eltradec/SCSI2SD-Proc/readme

Master is for CY8C5268
Branch is for CY8C5468
