eltradec/SCSI2SD-Proc/kicad/scsi2sd12.pdf

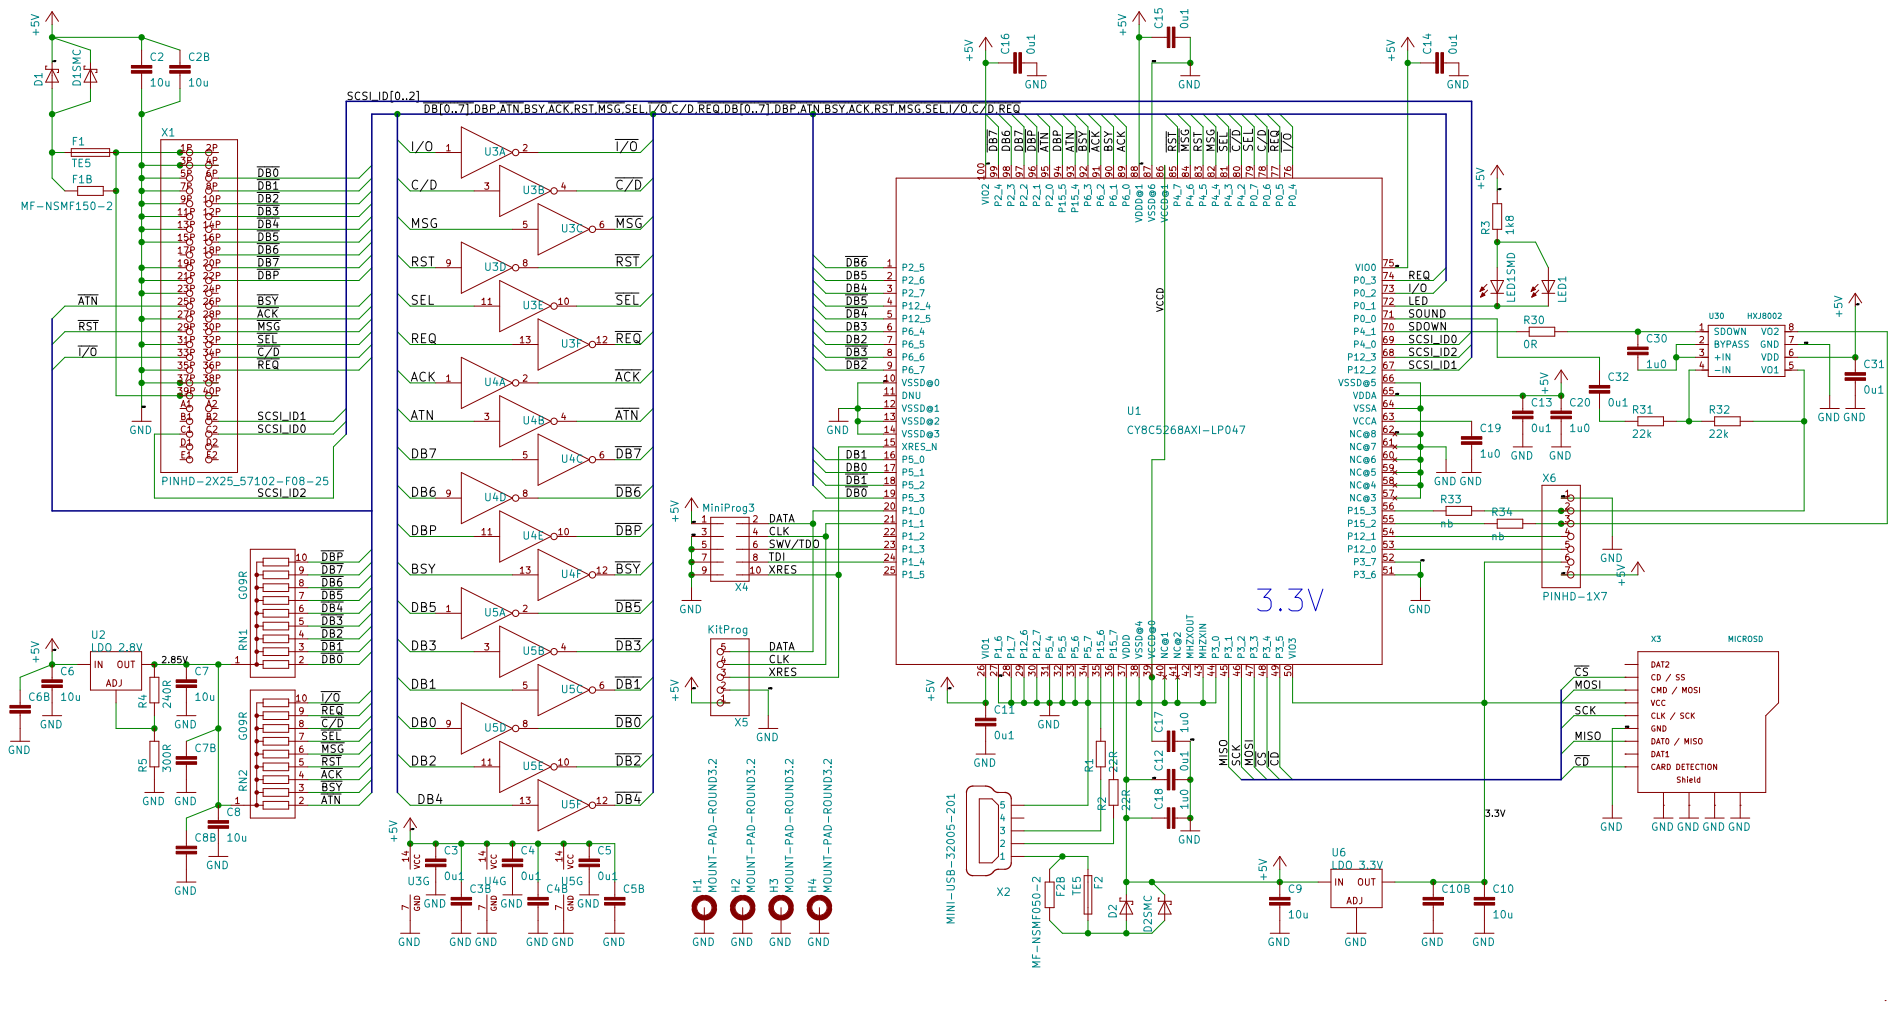
[picture p1: page 1]

DB[0..7],DBP,ATN,BSY,ACK,RST,MSG,SEL,I/O,C/D,REQ,DB[0..7],DBP,ATN,BSY,ACK,RST,MSG,SEL,I/O,C/D,REQ

CLK CLK DATA DATA

4 5 6

SWV/TDO
TDI

DAT1 DAT2 GND
CD / SS CLK / SCK CMD / MOSI DAT0 / MISO
