eltradec/SCSI2SD-Proc/kicad/scsi2sd12.sch

## KiCad design kicad/scsi2sd12.sch (2019-03-16)

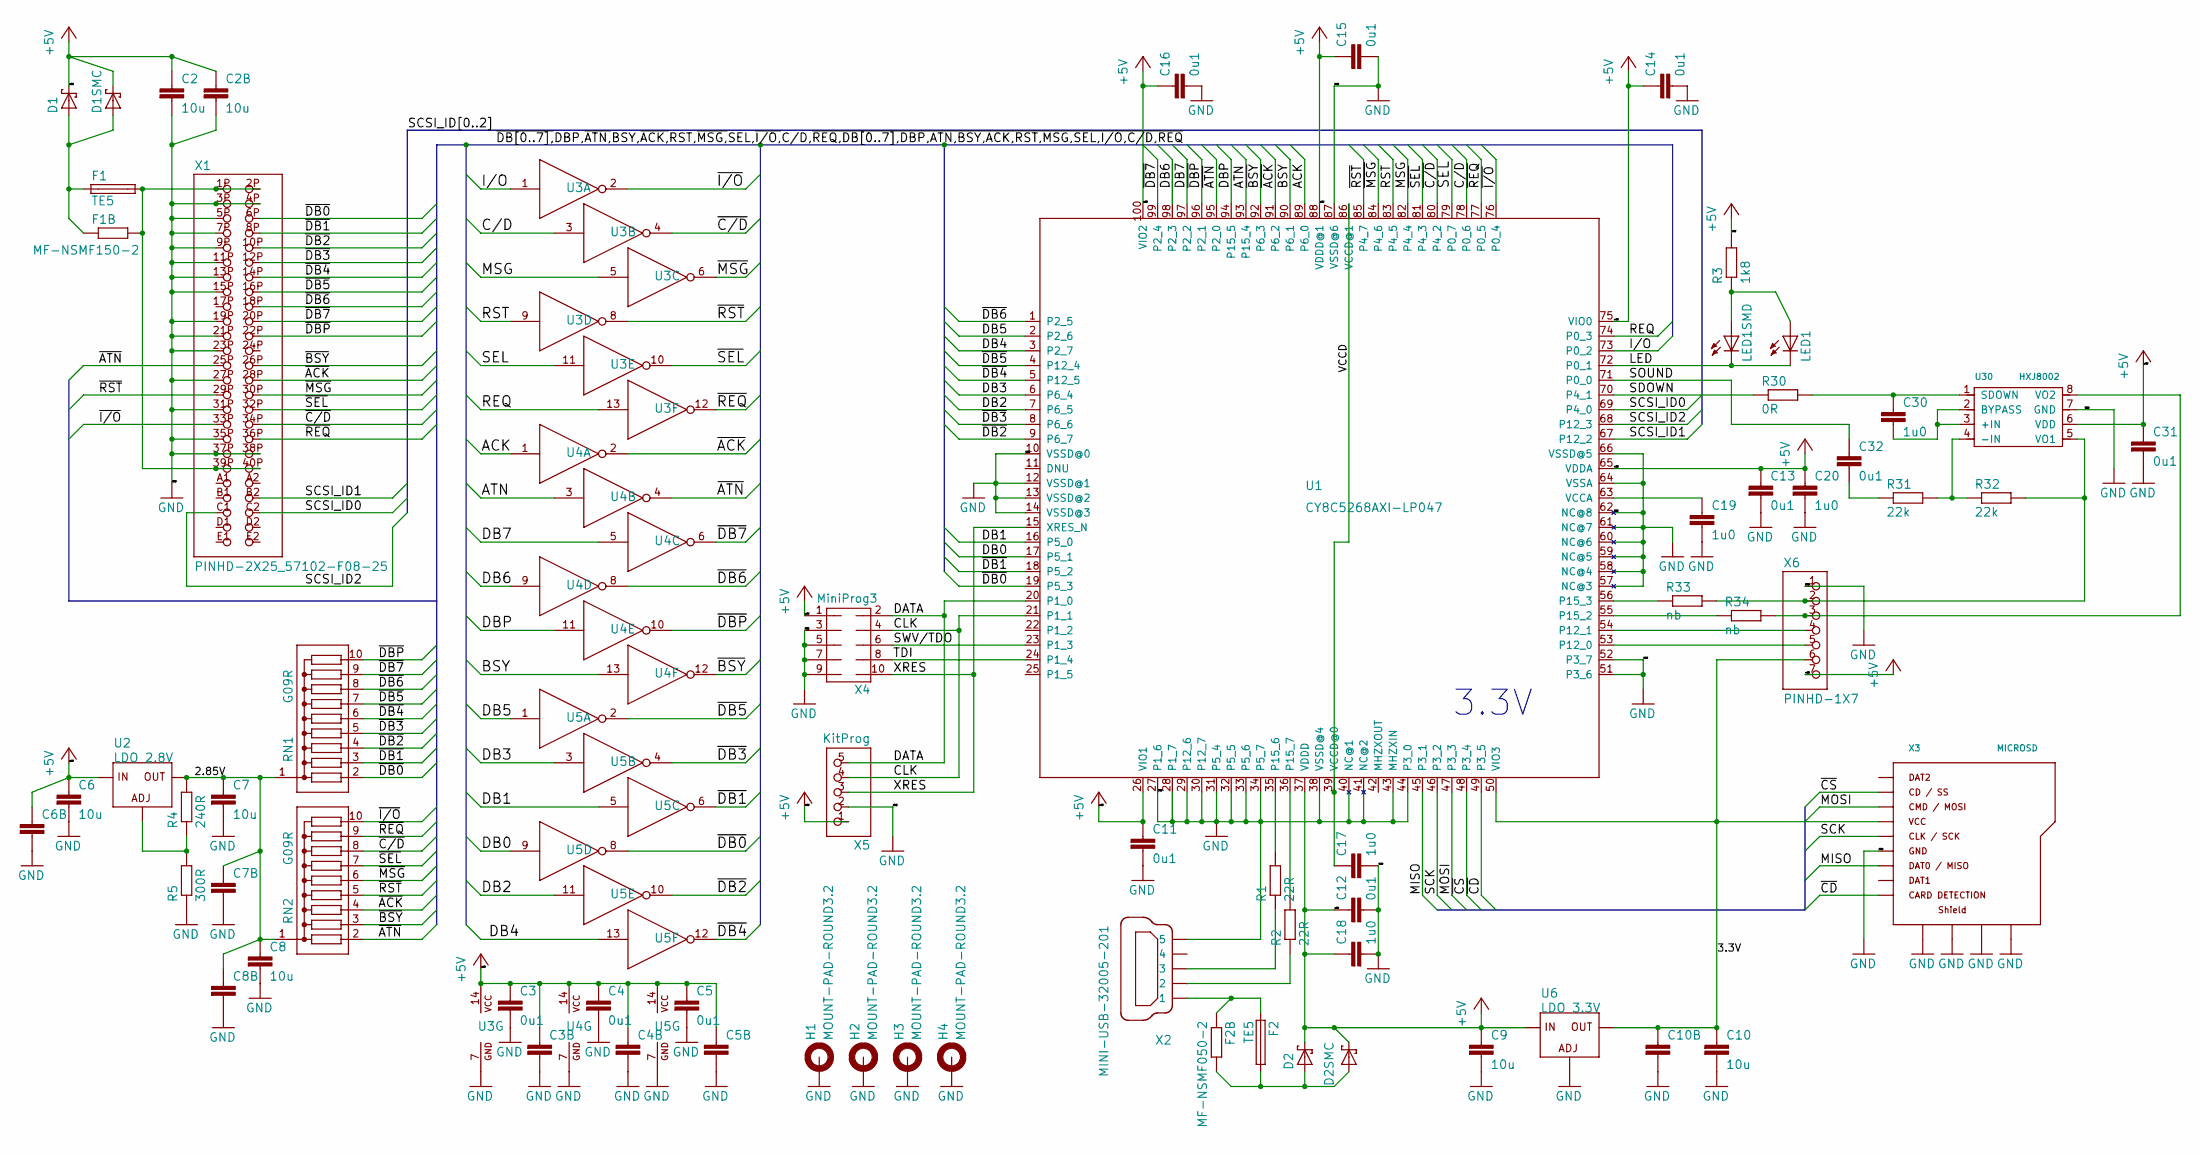
[picture p2: schematic scsi2sd12.sch]

Parts:
C2, C6, C7, C8, C9, C10: 10u; C0805K
C2B, C6B, C7B, C8B, C10B: 10u; C1206K
C3, C4, C5, C15: 0u1; C0603K
C3B, C4B, C5B, C11, C12, C13, C14, C16, C31, C32: 0u1; C0805K
C17, C18, C19, C20, C30: 1u0; C0805K
D1, D2: SCHOTTKY-DIODEDO214AC; DO214AC
D1SMC, D2SMC: SCHOTTKY-DIODESMC; SMC
F1, F2: TE5
F1B: MF-NSMF150-2; R1206
F2B: MF-NSMF050-2; R1206
H1, H2, H3, H4: MOUNT-PAD-ROUND3.2; 3,2-PAD
LED1: LEDCHIPLED_0805; CHIPLED_0805
LED1SMD: LED3MM
R1, R2: 22R; M0805
R3: 1k8; R0805
R4: 240R; M0805
R5: 300R; M0805
R30: 0R; M0805
R31, R32: 22k; M0805
R33, R34: nb; M0805
RN1, RN2: G09R; SIL10
U1: CY8C5268AXI-LP047; TQFP100-14X14
U2: LDO 2.8V; DPACK
U3, U4, U5: 7406D; SO14
U6: LDO 3.3V; DPACK
U30: HXJ8002; SOIC8-1.27-5X4MM
X1: PINHD-2X25_57102-F08-25; 57102-F08-25
X2: MINI-USB-32005-201; 32005-201
X3: MICROSD; MR**-AP*03**
X4: MiniProg3; PHB_1MM27_2X05_SNS
X5: KitProg; 1X05
X6: PINHD-1X7; 1X07

Connections:
2.85V: C7.1, C7B.1, C8.1, C8B.1, R4.2, RN1.1, RN2.1, U2.4 (OUT)
3.3V: C10.1, C10B.1, U1.50 (VIO3), U6.4 (OUT), X3.VCC, X6.6
+5V: C2.1, C2B.1, C3.1, C3B.1, C4.1, C4B.1, C5.1, C5B.1, C6.1, C6B.1, C9.1, C11.1, C12.1, C13.1, C14.1, C15.1, C16.1, C18.1, C20.1, C31.1, D1.C, D1SMC.C, D2.C, D2SMC.C, R3.2, U1.26 (VIO1), U1.37 (VDDD), U1.65 (VDDA), U1.75 (VIO0), U1.88 (VDDD@1), U1.100 (VIO2), U2.3 (IN), U3.14 (VCC), U4.14 (VCC), U5.14 (VCC), U6.3 (IN), U30.6 (VDD), X4.1, X5.1, X6.7
ACK: U1.89 (P6_0), U4.1 (I)
ATN: U1.93 (P15_4), U4.3 (I)
BSY: U1.90 (P6_1), U4.13 (I)
C/D: U1.78 (P0_6), U3.3 (I)
CLK: U1.21 (P1_1), X4.4, X5.4
DATA: U1.20 (P1_0), X4.2, X5.5
DB0: U1.17 (P5_1), U5.9 (I)
DB1: U1.16 (P5_0), U5.5 (I)
DB2: U1.7 (P6_5), U5.11 (I)
DB3: U1.6 (P6_4), U5.3 (I)
DB4: U1.3 (P2_7), U5.13 (I)
DB5: U1.2 (P2_6), U5.1 (I)
DB6: U1.98 (P2_3), U4.9 (I)
DB7: U1.97 (P2_2), U4.5 (I)
DBP: U1.94 (P15_5), U4.11 (I)
GND: C2.2, C2B.2, C3.2, C3B.2, C4.2, C4B.2, C5.2, C5B.2, C6.2, C6B.2, C7.2, C7B.2, C8.2, C8B.2, C9.2, C10.2, C10B.2, C11.2, C12.2, C13.2, C14.2, C15.2, C16.2, C17.2, C18.2, C19.2, C20.2, C31.2, H1.B3,2, H2.B3,2, H3.B3,2, H4.B3,2, R5.1, U1.10 (VSSD@0), U1.12 (VSSD@1), U1.13 (VSSD@2), U1.14 (VSSD@3), U1.27 (P1_6), U1.28 (P1_7), U1.29 (P12_6), U1.30 (P12_7), U1.31 (P5_4), U1.32 (P5_5), U1.33 (P5_6), U1.34 (P5_7), U1.38 (VSSD@4), U1.40 (NC@1), U1.41 (NC@2), U1.43 (MHZXIN), U1.44 (P3_0), U1.51 (P3_6), U1.52 (P3_7), U1.57 (NC@3), U1.58 (NC@4), U1.59 (NC@5), U1.60 (NC@6), U1.61 (NC@7), U1.62 (NC@8), U1.64 (VSSA), U1.66 (VSSD@5), U1.87 (VSSD@6), U3.7 (GND), U4.7 (GND), U5.7 (GND), U6.1 (ADJ), U30.7 (GND), X1.3P (3), X1.4P (4), X1.5P (5), X1.7P (7), X1.9P (9), X1.11P (11), X1.13P (13), X1.15P (15), X1.19P (19), X1.21P (21), X1.23P (23), X1.27P (27), X1.31P (31), X1.35P (35), X1.37P (37), X1.38P (38), X2.5, X3.GND, X3.SHD_1 (SHD1), X3.SHD_2 (SHD2), X3.SHD_3 (SHD3), X3.SHD_4 (SHD4), X4.3, X4.5, X4.7, X4.9, X5.2, X6.1
I/O: U1.73 (P0_2), U3.1 (I)
LED: LED1.C, LED1SMD.K (C), U1.72 (P0_1)
MISO: U1.45 (P3_1), X3.DAT0 (DAT0/MISO)
MOSI: U1.47 (P3_3), X3.CMD (CMD/MOSI)
MSG: U1.82 (P4_4), U3.5 (I)
unnamed: C19.1, U1.63 (VCCA)
unnamed: C30.1, R30.2, U30.1 (SDOWN)
unnamed: C30.2, U30.2 (BYPASS), U30.3 (+IN)
unnamed: C32.2, R31.1
unnamed: D1.A, D1SMC.A, F1.1, F1B.1
unnamed: D2.A, D2SMC.A, F2.2, F2B.2
unnamed: F1.2, F1B.2, X1.1P (1), X1.2P (2), X1.39P (39), X1.40P (40)
unnamed: F2.1, F2B.1, X2.1
unnamed: LED1.A, LED1SMD.A, R3.1
unnamed: R1.1, X2.3
unnamed: R1.2, U1.35 (P15_6)
unnamed: R2.1, X2.2
unnamed: R2.2, U1.36 (P15_7)
unnamed: R4.1, R5.2, U2.1 (ADJ)
unnamed: R31.2, R32.1, U30.4 (-IN)
unnamed: R32.2, R33.2, U30.5 (VO1), X6.2
unnamed: R33.1, U1.56 (P15_3)
unnamed: R34.1, U1.55 (P15_2)
unnamed: R34.2, U30.8 (VO2), X6.3
unnamed: U1.53 (P12_0), X6.5
unnamed: U1.54 (P12_1), X6.4
REQ: U1.74 (P0_3), U3.13 (I)
RST: U1.83 (P4_5), U3.9 (I)
SCK: U1.46 (P3_2), X3.CLK (CLK/SCK)
SCSI_ID0: U1.69 (P4_0), X1.C2 (46)
SCSI_ID1: U1.67 (P12_2), X1.B2 (44)
SCSI_ID2: U1.68 (P12_3), X1.C1 (45)
SDOWN: R30.1, U1.70 (P4_1)
SEL: U1.79 (P0_7), U3.11 (I)
SOUND: C32.1, U1.71 (P0_0)
SWV/TDO: U1.23 (P1_3), X4.6
TDI: U1.24 (P1_4), X4.8
VCCD: C17.1, U1.39 (VCCD@0), U1.86 (VCCD@1)
XRES: U1.15 (XRES_N), X4.10, X5.3
~ACK: RN2.4, U1.91 (P6_2), U4.2 (O), X1.28P (28)
~ATN: RN2.2, U1.95 (P2_0), U4.4 (O), X1.25P (25)
~BSY: RN2.3, U1.92 (P6_3), U4.12 (O), X1.26P (26)
~C/D: RN2.8, U1.80 (P4_2), U3.4 (O), X1.34P (34)
~CD: U1.49 (P3_5), X3.CARD_DETECTION (CARD_D)
~CS: U1.48 (P3_4), X3.DAT3/CS (CD/SS)
~DB0: RN1.2, U1.19 (P5_3), U5.8 (O), X1.6P (6)
~DB1: RN1.3, U1.18 (P5_2), U5.6 (O), X1.8P (8)
~DB2: RN1.4, U1.9 (P6_7), U5.10 (O), X1.10P (10)
~DB3: RN1.5, U1.8 (P6_6), U5.4 (O), X1.12P (12)
~DB4: RN1.6, U1.5 (P12_5), U5.12 (O), X1.14P (14)
~DB5: RN1.7, U1.4 (P12_4), U5.2 (O), X1.16P (16)
~DB6: RN1.8, U1.1 (P2_5), U4.8 (O), X1.18P (18)
~DB7: RN1.9, U1.99 (P2_4), U4.6 (O), X1.20P (20)
~DBP: RN1.10, U1.96 (P2_1), U4.10 (O), X1.22P (22)
~I/O: RN2.10, U1.76 (P0_4), U3.2 (O), X1.33P (33)
~MSG: RN2.6, U1.84 (P4_6), U3.6 (O), X1.30P (30)
~REQ: RN2.9, U1.77 (P0_5), U3.12 (O), X1.36P (36)
~RST: RN2.5, U1.85 (P4_7), U3.8 (O), X1.29P (29)
~SEL: RN2.7, U1.81 (P4_3), U3.10 (O), X1.32P (32)

Notes on the sheet:
3.3V
