eltradec/SCSI2SD-Proc/src/config.c

//	Copyright (C) 2014 Michael McMaster <michael@codesrc.com>
//
//	This file is part of SCSI2SD.
//
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
#include "device.h"
#include "config.h"
#include "debug.h"
#include "USBFS.h"
#include "led.h"

#include "scsi.h"
#include "scsiPhy.h"
#include "disk.h"
#include "trace.h"

#include "../src/include/scsi2sd.h"
#include "../src/include/hidpacket.h"

#include <string.h>

static const uint16_t FIRMWARE_VERSION = 0x0482;

// 1 flash row
static const uint8_t DEFAULT_CONFIG[256] =
{
	0x80, 0x00, 0x00, 0x00, 0x00, 0x00, 0x00, 0x00, 0xFF, 0xFF, 0x3F, 0x00,
	0x00, 0x02, 0x3F, 0x00, 0xFF, 0x00, 0x20, 0x63, 0x6F, 0x64, 0x65, 0x73,
	0x72, 0x63, 0x20, 0x20, 0x20, 0x20, 0x20, 0x20, 0x20, 0x20, 0x20, 0x53,
	0x43, 0x53, 0x49, 0x32, 0x53, 0x44, 0x20, 0x31, 0x2E, 0x30, 0x31, 0x32,
	0x33, 0x34, 0x35, 0x36, 0x37, 0x38, 0x31, 0x32, 0x33, 0x34, 0x35, 0x36,
	0x37, 0x38, 0x00, 0x00
};

enum USB_ENDPOINTS
{
	USB_EP_OUT = 1,
	USB_EP_IN = 2,
	USB_EP_COMMAND = 3,
	USB_EP_DEBUG = 4
};
enum USB_STATE
{
	USB_IDLE,
	USB_DATA_SENT
};

static uint8_t hidBuffer[USBHID_LEN];

static int usbInEpState;
static int usbDebugEpState;
static int usbReady;

static void initBoardConfig(BoardConfig* config) {
	memcpy(
		config,
		(
			(CY_FLASH_BASE +
			(CY_FLASH_SIZEOF_ARRAY * (size_t) SCSI_CONFIG_ARRAY) +
			(CY_FLASH_SIZEOF_ROW * SCSI_CONFIG_BOARD_ROW))
			),
		sizeof(BoardConfig)); // RM to correct

	if (memcmp(config->magic, "BCFG", 4)) {
		// Set a default from the deprecated flags, or 0 if
		// there is no initial config.
		config->flags = getConfigByIndex(0)->flagsDEPRECATED;

		config->selectionDelay = 255; // auto
		config->flags6 = S2S_CFG_ENABLE_TERMINATOR;
	}
}

void configInit(BoardConfig* config)
{
	// The USB block will be powered by an internal 3.3V regulator.
	// The PSoC must be operating between 4.6V and 5V for the regulator
	// to work.
	USBFS_Start(0, USBFS_5V_OPERATION);
	usbInEpState = usbDebugEpState = USB_IDLE;
	usbReady = 0; // We don't know if host is connected yet.

	int invalid = 1;
	uint8_t* rawConfig = (getConfigByIndex(0));
	int i;
	for (i = 0; i < 64; ++i)
	{
		if (rawConfig[i])
		{
			invalid = 0;
			break;
		}
	}
	if (invalid)
	{
		// Save a default config.
		CySetTemp();
		CyWriteRowData(SCSI_CONFIG_ARRAY, SCSI_CONFIG_0_ROW, DEFAULT_CONFIG);
	}

	initBoardConfig(config);
}

static void
readFlashCommand(const uint8_t* cmd, size_t cmdSize)
{
	if (cmdSize < 3)
	{
		return; // ignore.
	}
	uint8_t flashArray = cmd[1];
	uint8_t flashRow = cmd[2];

	uint8_t* flash = (CY_FLASH_BASE +
		(CY_FLASH_SIZEOF_ARRAY * (size_t) flashArray) +
		(CY_FLASH_SIZEOF_ROW * (size_t) flashRow));

	hidPacket_send(flash, SCSI_CONFIG_ROW_SIZE);
}

static void
writeFlashCommand(const uint8_t* cmd, size_t cmdSize)
{
	if (cmdSize < 259)
	{
		return; // ignore.
	}
	uint8_t flashArray = cmd[257];
	uint8_t flashRow = cmd[258];

	// Be very careful not to overwrite the bootloader or other\r
	// code. Bootloader updates no longer supported. Use v5.1 board
	// instead.
	if ((flashArray != SCSI_CONFIG_ARRAY) ||
		(flashRow < SCSI_CONFIG_4_ROW) ||
		(flashRow >= SCSI_CONFIG_3_ROW + SCSI_CONFIG_ROWS))
	{
		uint8_t response[] = { CONFIG_STATUS_ERR };
		hidPacket_send(response, sizeof(response));
	}

	CySetTemp();
	int status = CyWriteRowData(flashArray, flashRow, cmd + 1);

	uint8_t response[] =
	{
		status == CYRET_SUCCESS ? CONFIG_STATUS_GOOD : CONFIG_STATUS_ERR
	};
	hidPacket_send(response, sizeof(response));
}

static void
pingCommand()
{
	uint8_t response[] =
	{
		CONFIG_STATUS_GOOD
	};
	hidPacket_send(response, sizeof(response));
}

static void
sdInfoCommand()
{
	uint8_t response[sizeof(sdDev.csd) + sizeof(sdDev.cid)];
	memcpy(response, sdDev.csd, sizeof(sdDev.csd));
	memcpy(response + sizeof(sdDev.csd), sdDev.cid, sizeof(sdDev.cid));

	hidPacket_send(response, sizeof(response));
}


static void
scsiTestCommand()
{
	int resultCode = scsiSelfTest();
	uint8_t response[] =
	{
		resultCode == 0 ? CONFIG_STATUS_GOOD : CONFIG_STATUS_ERR,
		resultCode
	};
	hidPacket_send(response, sizeof(response));
}

static void
processCommand(const uint8_t* cmd, size_t cmdSize)
{
	switch (cmd[0])
	{
	case CONFIG_PING:
		pingCommand();
		break;

	case CONFIG_READFLASH:
		readFlashCommand(cmd, cmdSize);
		break;

	case CONFIG_WRITEFLASH:
		writeFlashCommand(cmd, cmdSize);
		break;

	case CONFIG_REBOOT:
		Bootloadable_1_Load();
		break;

	case CONFIG_SDINFO:
		sdInfoCommand();
		break;

	case CONFIG_SCSITEST:
		scsiTestCommand();
		break;

	case CONFIG_NONE: // invalid
	default:
		break;
	}
}

void configPoll()
{
	int reset = 0;
	if (!usbReady || USBFS_IsConfigurationChanged())
	{
		reset = 1;
	}
	usbReady = USBFS_bGetConfiguration();

	if (!usbReady)
	{
		return;
	}

	if (reset)
	{
		USBFS_EnableOutEP(USB_EP_OUT);
		USBFS_EnableOutEP(USB_EP_COMMAND);
		usbInEpState = usbDebugEpState = USB_IDLE;
	}

	if(USBFS_GetEPState(USB_EP_OUT) == USBFS_OUT_BUFFER_FULL)
	{
		ledOn();

		// The host sent us some data!
		int byteCount = USBFS_GetEPCount(USB_EP_OUT);
		USBFS_ReadOutEP(USB_EP_OUT, hidBuffer, sizeof(hidBuffer));
		hidPacket_recv(hidBuffer, byteCount);

		size_t cmdSize;
		const uint8_t* cmd = hidPacket_getPacket(&cmdSize);
		if (cmd && (cmdSize > 0))
		{
			processCommand(cmd, cmdSize);
		}

		// Allow the host to send us another updated config.
		USBFS_EnableOutEP(USB_EP_OUT);

		ledOff();
	}

	switch (usbInEpState)
	{
	case USB_IDLE:
		{
			const uint8_t* nextChunk = hidPacket_getHIDBytes(hidBuffer);

			if (nextChunk)
			{
				USBFS_LoadInEP(USB_EP_IN, nextChunk, sizeof(hidBuffer));
				usbInEpState = USB_DATA_SENT;
			}
		}
		break;

	case USB_DATA_SENT:
		if (USBFS_bGetEPAckState(USB_EP_IN))
		{
			// Data accepted.
			usbInEpState = USB_IDLE;
		}
		break;
	}
}

void debugPoll()
{
	if (!usbReady)
	{
		return;
	}

	if(USBFS_GetEPState(USB_EP_COMMAND) == USBFS_OUT_BUFFER_FULL)
	{
		// The host sent us some data!
		int byteCount = USBFS_GetEPCount(USB_EP_COMMAND);
		USBFS_ReadOutEP(USB_EP_COMMAND, (uint8 *)&hidBuffer, byteCount);

		if (byteCount >= 1 &&
			hidBuffer[0] == 0x01)
		{
			// Reboot command.
			Bootloadable_1_Load();
		}

		// Allow the host to send us another command.
		// (assuming we didn't reboot outselves)
		USBFS_EnableOutEP(USB_EP_COMMAND);
	}

	switch (usbDebugEpState)
	{
	case USB_IDLE:
		memcpy(&hidBuffer, &scsiDev.cdb, 12);
		hidBuffer[12] = scsiDev.msgIn;
		hidBuffer[13] = scsiDev.msgOut;
		hidBuffer[14] = scsiDev.lastStatus;
		hidBuffer[15] = scsiDev.lastSense;
		hidBuffer[16] = scsiDev.phase;
		hidBuffer[17] = SCSI_ReadFilt(SCSI_Filt_BSY);
		hidBuffer[18] = SCSI_ReadFilt(SCSI_Filt_SEL);
		hidBuffer[19] = SCSI_ReadFilt(SCSI_Filt_ATN);
		hidBuffer[20] = SCSI_ReadFilt(SCSI_Filt_RST);
		hidBuffer[21] = scsiDev.rstCount;
		hidBuffer[22] = scsiDev.selCount;
		hidBuffer[23] = scsiDev.msgCount;
		hidBuffer[24] = scsiDev.cmdCount;
		hidBuffer[25] = scsiDev.watchdogTick;
		hidBuffer[26] = blockDev.state;
		hidBuffer[27] = scsiDev.lastSenseASC >> 8;
		hidBuffer[28] = scsiDev.lastSenseASC;
		hidBuffer[29] = scsiReadDBxPins();
		hidBuffer[30] = LastTrace;

		hidBuffer[58] = sdDev.capacity >> 24;
		hidBuffer[59] = sdDev.capacity >> 16;
		hidBuffer[60] = sdDev.capacity >> 8;
		hidBuffer[61] = sdDev.capacity;

		hidBuffer[62] = FIRMWARE_VERSION >> 8;
		hidBuffer[63] = FIRMWARE_VERSION;

		USBFS_LoadInEP(USB_EP_DEBUG, (uint8 *)&hidBuffer, sizeof(hidBuffer));
		usbDebugEpState = USB_DATA_SENT;
		break;

	case USB_DATA_SENT:
		if (USBFS_bGetEPAckState(USB_EP_DEBUG))
		{
			// Data accepted.
			usbDebugEpState = USB_IDLE;
		}
		break;
	}
}

CY_ISR(debugTimerISR)
{
	Debug_Timer_ReadStatusRegister();
	Debug_Timer_Interrupt_ClearPending();
	uint8 savedIntrStatus = CyEnterCriticalSection();
	debugPoll();
	CyExitCriticalSection(savedIntrStatus);
}

void debugInit()
{
	Debug_Timer_Interrupt_StartEx(debugTimerISR);
	Debug_Timer_Start();
}

void debugPause()
{
	Debug_Timer_Stop();
}

void debugResume()
{
	Debug_Timer_Start();
}

int isDebugEnabled()
{
	return usbReady;
}

// Public method for storing MODE SELECT results.
void configSave(int scsiId, uint16_t bytesPerSector)
{
	int cfgIdx;
	for (cfgIdx = 0; cfgIdx < MAX_SCSI_TARGETS; ++cfgIdx)
	{
		const TargetConfig* tgt = getConfigByIndex(cfgIdx);
		if ((tgt->scsiId & CONFIG_TARGET_ID_BITS) == scsiId)
		{
			// Save row to flash
			// We only save the first row of the configuration
			// this contains the parameters changeable by a MODE SELECT command
			uint8_t rowData[CYDEV_FLS_ROW_SIZE];
			TargetConfig* rowCfgData = (TargetConfig*)&rowData;
			memcpy(rowCfgData, tgt, sizeof(rowData));
			rowCfgData->bytesPerSector = bytesPerSector;

			CySetTemp();
			CyWriteRowData(
				SCSI_CONFIG_ARRAY,
				SCSI_CONFIG_0_ROW + (cfgIdx * SCSI_CONFIG_ROWS),
				(uint8_t*)rowCfgData);
			return;
		}
	}
}


const TargetConfig* getConfigByIndex(int i)
{
	if (i <= 3)
	{
		size_t row = SCSI_CONFIG_0_ROW + (i * SCSI_CONFIG_ROWS);
		return (const TargetConfig*)
			(
				CY_FLASH_BASE +
				(CY_FLASH_SIZEOF_ARRAY * (size_t) SCSI_CONFIG_ARRAY) +
				(CY_FLASH_SIZEOF_ROW * row)
				);
	} else {
		size_t row = SCSI_CONFIG_4_ROW + ((i-4) * SCSI_CONFIG_ROWS);
		return (const TargetConfig*)
			(
				CY_FLASH_BASE +
				(CY_FLASH_SIZEOF_ARRAY * (size_t) SCSI_CONFIG_ARRAY) +
				(CY_FLASH_SIZEOF_ROW * row)
				);
	}
}

const TargetConfig* getConfigById(int scsiId)
{
	int i;
	for (i = 0; i < MAX_SCSI_TARGETS; ++i)
	{
		const TargetConfig* tgt = getConfigByIndex(i);
		if ((tgt->scsiId & CONFIG_TARGET_ID_BITS) == scsiId)
		{
			return tgt;
		}
	}
	return NULL;

}
